omar7altawil/Sumo-Robot/README.md

# Sumo-Robot

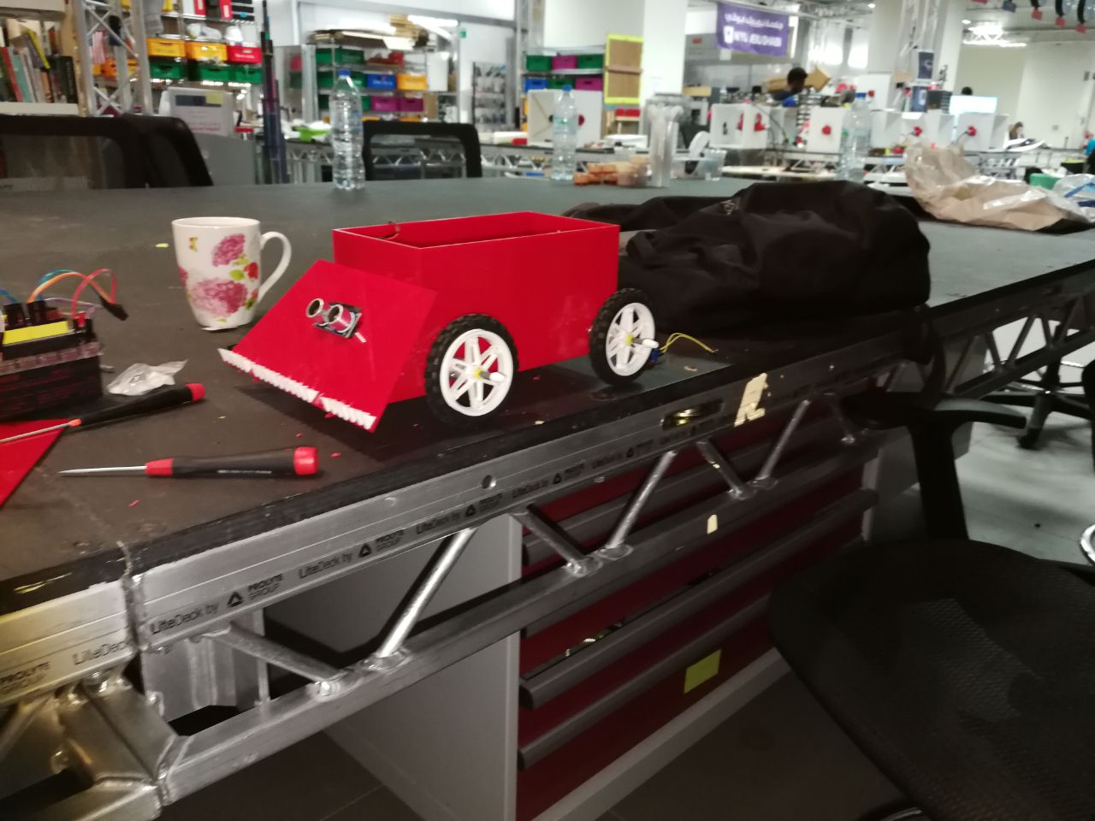
[picture p1: 3D/1.png]


Our project is about designing, assembling and programming our own Sumo
Robot. We had a budget of 100 US Dollar and were not allowed to exceed
it.At the end of the semester, there were a competition to see which Sumo
Robot is better and we will hopefully win the competition.

for the full report read(Project_micro.pdf)
