omar7altawil/Sumo-Robot/Micro_Project.pdf

# Project Report

# Sumo Robot Using Arduino

Ahmad Hashi 1046819

Omar Altawil 1047982

Mohamed Alnuaimi 1059177

Mohammed Tareq 1059223

Supervised By: Prof.Mohammad Ghazal

Eng. Yasmina Al Khalil

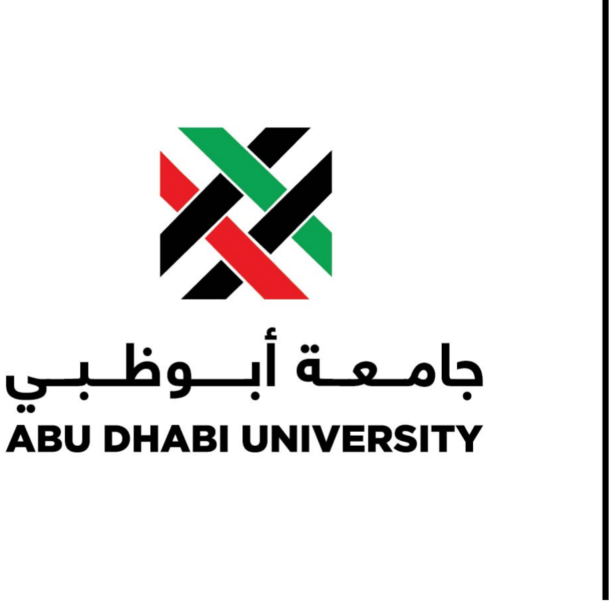
[picture p2: figure]

Submitted: December 15, 2017

1

# Contents

1 Introduction | 3
2 Procedure | 3
2.1 Motors | | 3
2.2 Sensors | | 6
2.3 The Chassis | 13
2.4 Extra : The Piezo | 17
2.5 The FSM | 19
2.6 The Final Code | 20
3 Conclusion | 29
4 Appendix | 29

# List of Figures

1 | The Motor Shield | | 4
2 | The H-Bridge | | 5
3 | The L9110S | | 5
4 | The L298n | | 6
5 | The Ultrasonic sensor | | 7
6 | The IR sensor | | 8
7 | The Remote controller(IR) | 10
8 | The Remote controller(Bluetooth) | 12
9 | PCB Broad 1 | 13
10 | PCB Broad 2 | 14
11 | The 3D Model | 15
12 | The Wheels | 15
13 | The Final Chassis | 16
14 | The Connections | 16
15 | The Wheel | 17
16 | The Piezo | 17
17 | The Final FSM | 19

2

# List of Tables

Abstract

This project is about creating you’re own Sumo Robot, designing and coding were up to us in the process of making our Robot.The winner of the Sumo Robot fight competition will be considered the best Robot design.The process of making our robot included making a PCB design, a 3D Design and a Design using some plastic and laser cutting. We faced a lot of challenges through out our project mainly on the chassis part. The coding was very fun to do, and we feel like we learned a lot about the embedded systems thanks to this project.

# 1 Introduction

Our project is about designing, assembling and programming our own Sumo Robot. We had a budget of 100 US Dollar and were not allowed to exceed it.At the end of the semester, there were a competition to see which Sumo Robot is better and we will hopefully win the competition.

# 2 Procedure

Here, we are going to talk about everything that we did, including the dif-ficulties that we faced, and we will end up with the FSM and the Final code.

## 2.1 Motors

In our robot, we had four 12 V DC motors which were supplied using a 12 volt(1.2AH)battery. some of the stuff didn’t make it to the final design due to reasons that are going to be mentioned and explained in the rest of the project report.

- Motor Shield : it’s driver module for motors that allows the user to control the state of the motor(on/off), the speed and the direction of the motor [1].We didn’t use the motor shield due to having insufficient pins for the rest of the sensors. A picture of the motor shield is shown in the figure 1.

3

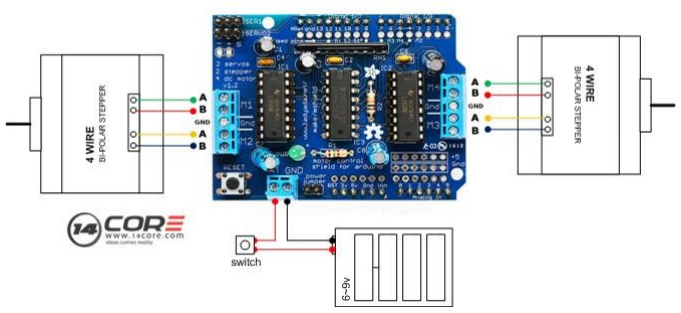
[picture p3: figure]

Figure 1: The Motor Shield

- L293d (H-Bridge) : To fix the problem that we faced with the Motor Shield, we decided to use L293d. We solider-out the l293d (2) from the motor shield, and we used to control the four motors. This was our ideal method of controlling the motors, the L293d had a very convenient size and it would have done its job fair and square.However, due to facing problems with the 3D design and the PCB print,we had to do the soldering by ourselves,but the connections were too big and it didn’t fit into our chassis.The L293d couldn’t make it to the final design.A picture of the L293d is shown in the figure 2.

4

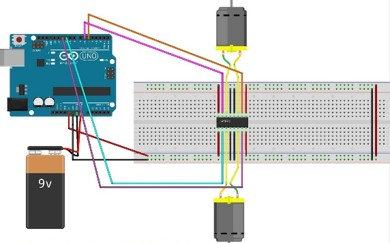
[picture p4: figure]

Figure 2: The H-Bridge

- L9110S : After having problems with the H-Bridge, we decided to use the L9110S motor driver. The L9110S was small, cheap and would fit perfectly in our chassis, and according to its data sheet it said that it can handle an range from 3.5 to 12 volt which was exactly what we wanted. Yet again, we faced an other problem, when we supplied the L9110S with 12v it worked approximately for 30 seconds before burning up due to overheat. Thus,the L9110S couldn’t make it to the final design.A picture of the L9110S is shown in the figure 3.

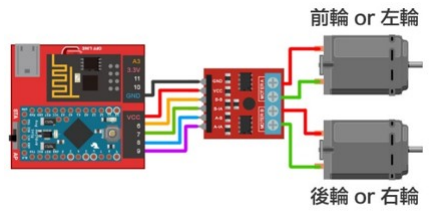
[picture p5: figure]

Figure 3: The L9110S

5

- L298n : we got this motor driver as a final solution, although the size of this motor driver was not what we intended to have in the beginning, it was the only thing that would work without overheating nor taking extra pins and its connections were acceptable. Therefor,the L298n was included into our final design.A picture of the L298n is shown in the figure 4.

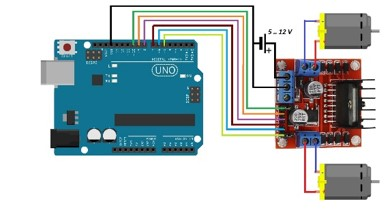
[picture p6: figure]

Figure 4: The L298n

## 2.2 Sensors

Sensors in general are devices that detects and responds to some type of input from the physical environment. The specific input could be light, heat, motion, moisture, pressure, or any one of a great number of other environmental phenomena [2].

- Ultrasonic sensor : An Ultrasonic sensor is a device that can measure the distance from object A to object B using sound waves.It measures distance by sending out a sound wave at a specific frequency and waits for its Eco to bounce back. By recording the elapsed time between the sound wave being generated and the sound wave bouncing back, it is possible to calculate the distance between the sonar sensor and the object [3]. We used this sensor to detect whether there is an other robot in front of our robot or not.A picture of the Ultrasonic sensor is shown in the figure 5.

6

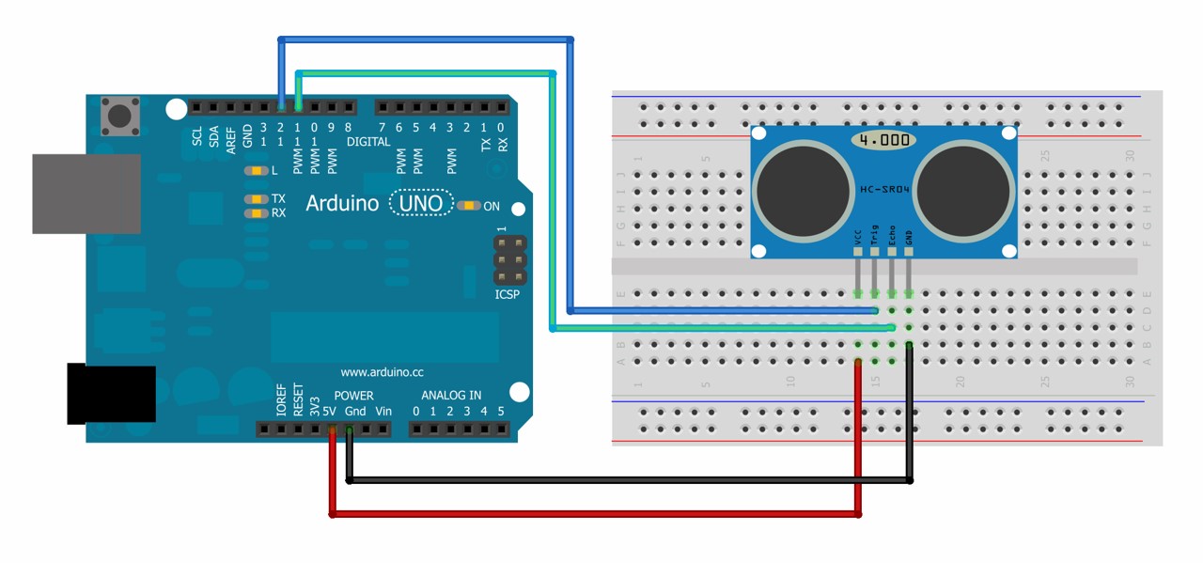
[picture p7: figure]

Figure 5: The Ultrasonic sensor

In the code, instead of using pulseIn() function, we included < NewP ing.h > library [4]. The test code of the sensor is shown downward :-

1 | #include <NewPing.h>
2 | #define TRIGGER_PIN A5
3 | #define ECHO_PIN | A5
4 | #define MAX_DISTANCE 200

5
6 NewPing sonar(TRIGGER_PIN, ECHO_PIN, MAX_DISTANCE);

7
8 | void setup() {
9 | Serial.begin(9600);
10 | pinMode(A0,OUTPUT);
11 | }

12
13 | void loop() {
14 | delay(50);
15 | Serial.print("Ping: ");
16 | Serial.print(sonar.ping_cm());
17 | Serial.println("cm");

18
19 | if(sonar.ping_cm()<8 && sonar.ping_cm()>0 )
20 | digitalWrite(A0,HIGH);
21 | if(sonar.ping_cm()>8)
22 | digitalWrite(A0,LOW);
23 | }

7

We used the function sonar.pingcm() to obtain the distance in cm. In the test code, we made the sensor work in a range of 0 to 200 cm in the new ping constructor and we set up a range of 0 to 8 cm for our output X to be HIGH. We had a delay of 50 milliseconds between each ping.

- IR Sensor : IR Sensor works by using a specific light sensor to detect a select light wavelength in the Infra-Red (IR) spectrum. The sensor has two main parts, one part sends the IR while the other part senses the reflected light, so it is possible to have a sensor that can return the value of the reflected light and it can be used to measure how ”bright” the object is [5].We used the IR sensor to detect whether the robot has reached the edge of the arena or not.A picture of the IR sensor is shown in the figure 6.

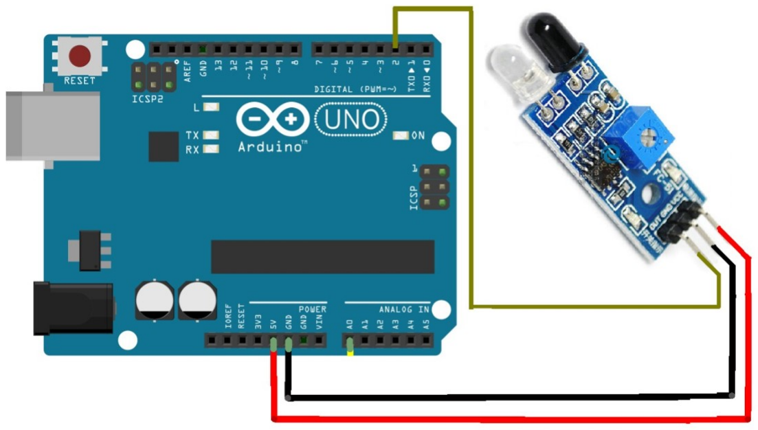
[picture p8: figure]

Figure 6: The IR sensor

8

This is our test code for the IR sensor :-

1 | int obstaclePin = 6; // This is our input pin
2 | int hasObstacle = LOW; // HIGH MEANS NO OBSTACLE

3
4 | void setup() {
5 | pinMode(A0, OUTPUT);
6 | pinMode(obstaclePin, INPUT);
7 | Serial.begin(9600);
8 | }
9 | void loop() {
10 | hasObstacle = digitalRead(obstaclePin); //Reads the output
| of the obstacle sensor from the 7th PIN of the Digital
| section of the arduino
11 | if (hasObstacle == HIGH) //LOW means something is ahead, so
| it illuminates the 13th Port connected to an LED
12 | {
13 | Serial.println("Stop something is ahead!!");
14 | digitalWrite(7, HIGH);//Illuminates the 13th Port LED
15 | }
16 | else
17 | {
18 | Serial.println("Path is clear");
19 | digitalWrite(7, LOW);
20 | }
21 | delay(200);
22 | }

In the test code, when hasObstacle is HIGH it means that the sensor is saying that there is some obstacle ahead and then a light is turned on to indicate that.

- The Remote controller : Our first choice was the IR remote controller due to its simplicity and reasonable price, but we didn’t use it because we faced A weird problem with it, the sensor stopped responding when the motors started moving. After debugging we noticed that the IR sensor works fine within 0 to 70 of analog input and when we tried to exceed that range it stops working. More debugging led us to notice that if we put the IR sensor away from the motor it works fine (up to
255) so the problem might be with the magnetic field that is generated

9

by the motors.A picture of the IR sensor is shown in the figure 7.

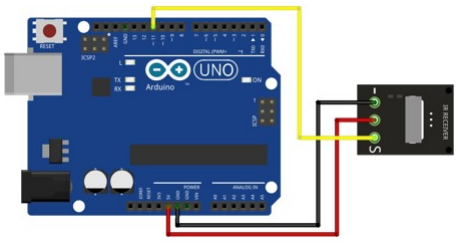
[picture p9: figure]

Figure 7: The Remote controller(IR)

In the test code for the remote using IR, we were controlling four motors. In order to use the IR remote, we had to include < IRremote.h > library.

1 #include <IRremote.h>

2
3 | int RECV_PIN = A4;
4 | IRrecv irrecv(RECV_PIN);
5 | decode_results results;

6
7 | #define BUTTON_front 0xEFA25D
8 | #define BUTTON_back 0xEFB24D
9 | #define BUTTON_left 0xEF50AF
10 | #define BUTTON_right 0xEF12ED
11 | #define BUTTON_speedup 0xEFE817
12 | #define BUTTON_speeddown 0xEF6897

13
14 | void setup()
15 | {
16 | Serial.begin(9600);
17 | irrecv.enableIRIn();
18 | }
19 | void loop() {
20 | if (irrecv.decode(&results)){

10

21 | Serial.println(results.value, HEX );
22 | if (results.value == BUTTON_front){
23 | // do something | }
24 | if (results.value == BUTTON_back){
25 | // do something | }
26 | if (results.value == BUTTON_back){
27 | // do something
28 | }
29 | if (results.value == BUTTON_back){
30 | // do something
31 | }
32 | irrecv.resume();
33 | }
34 | }

We faced one problem in our code which was the fact that new ping
library and IR library were using the same timer (timer 1), so we edited
new ping library and changed the timerenablefromtruetof alse.Althoughwewereabletof ixoneproblem, theproblemwiththeunstablecontrolmadethissensorexcludedfromthef inaldesign.
- Bluetooth hc-05 : HC-05 module is an easy to use Bluetooth SPP (Serial Port Protocol) module, designed for transparent wireless serial connection setup.It can function as both master and slave or we can say its a transceiver device. Master in referring to the controller or the device who sends the control signal, while slave in referring to the device that receives and obeys the control signal [6].We used a mobile app to control our robot via Bluetooth.A picture of the hc-05 sensor is shown in the figure 8.

The test code for the Bluetooth sensor is shown downward :-

1 | int state;
2 | int flag=0;
3 | int stateStop=0;
4 | void setup() {

5
6 | Serial.begin(9600);
7 | }

8
9 | void loop() {
10 | if(Serial.available() > 0){

11

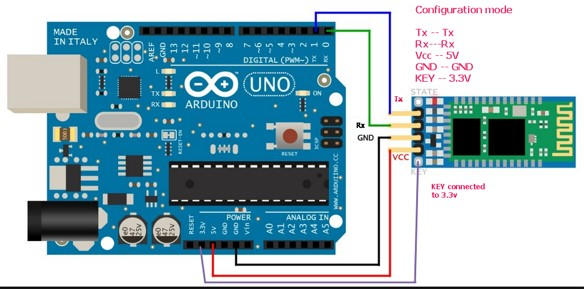
[picture p10: figure]

Figure 8: The Remote controller(Bluetooth)

11 | state = Serial.read();
12 | flag=0;
13 | }
14 | if (state == ’u’) {
15 | // Do something
16 | if(flag == 0){
17 | Serial.println("u is pressed");
18 | flag=1;
19 | }
20 | }
21 | else if (state == ’d’) {
22 | // Do something
23 | if(flag == 0){
24 | Serial.println("d is pressed");
25 | flag=1;
26 | }
27 | }
28 | else if (state == ’s’ || stateStop == 1) {
29 | // Do something
30 | if(flag == 0){
31 | Serial.println("s is pressed");
32 | flag=1;
33 | }
34 | stateStop=0;
35 | }
36 | else if (state == ’a’) {

12

37 | // Do something
38 | if(flag == 0){
39 | Serial.println("a is pressed");
40 | flag=1;
41 | }
42 | stateStop=0;
43 | }

44

45 }

## 2.3 The Chassis

Here we discuss how did we make our chassis.

- PCB Print :- A printed circuit board (PCB) is a board base for physi-cally supporting and wiring the surface-mounted and socketed compo-nents in most electronics [7].This was what we intended to have in the beginning of our project, but due to not having enough time and the 3D modeling problem, the PCB print of our circuit didn’t make it to the final design.We used eagle to design our PCB,and a picture of the design is shown in the figure 9 and 10.

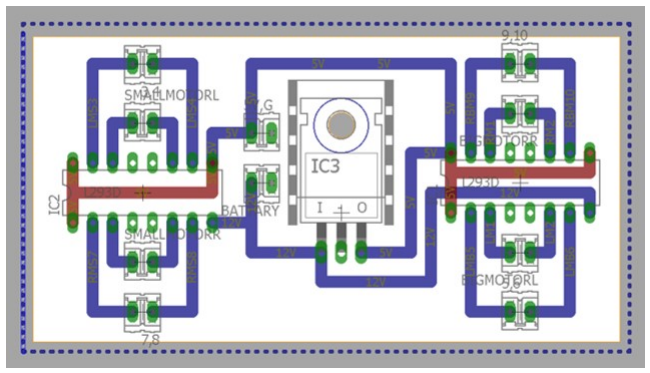
[picture p11: figure]

Figure 9: PCB Broad 1

13

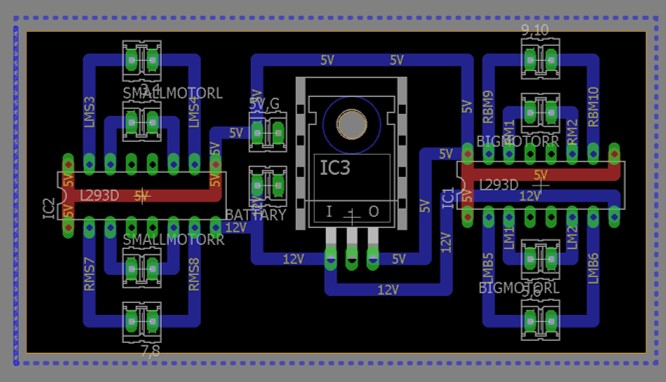
[picture p12: figure]

Figure 10: PCB Broad 2

- 3D Print :- A 3D printer is a computer-aided manufacturing (CAM) device that creates three-dimensional objects. Like a traditional printer, a 3D printer receives digital data from a computer as input. However, instead of printing the output on paper, a 3D printer builds a three-dimensional model out of a custom material [8].We made a 3D design of our chassis using Tinkercad, and printed it in the labs, our design had a length of 20 cm, a weight of 15 cm and a height of 6 cm. After printing, we were surprised that after the rescaling process, the design shrinked significantly and it didn’t even fit one motor, thus we were not able to use it and it wasn’t included in the final design.A picture of the 3D model is shown in the figure 11 and 12.

14

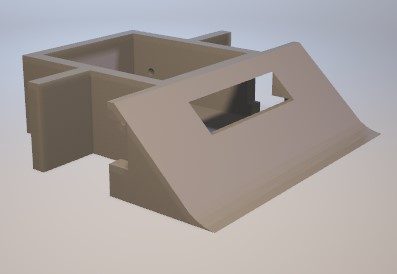
[picture p13: figure]

Figure 11: The 3D Model

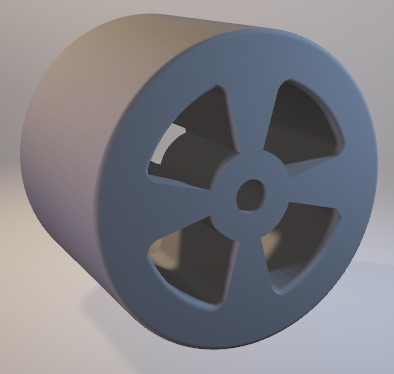
[picture p14: figure]

Figure 12: The Wheels

- plastic Laser Cutting :- This was our last resolve, getting thick pieces of plastic and use laser to form it in our desired shape.A picture of the final model and it’s connections are shown in the figure 13, 14 and 15.

15

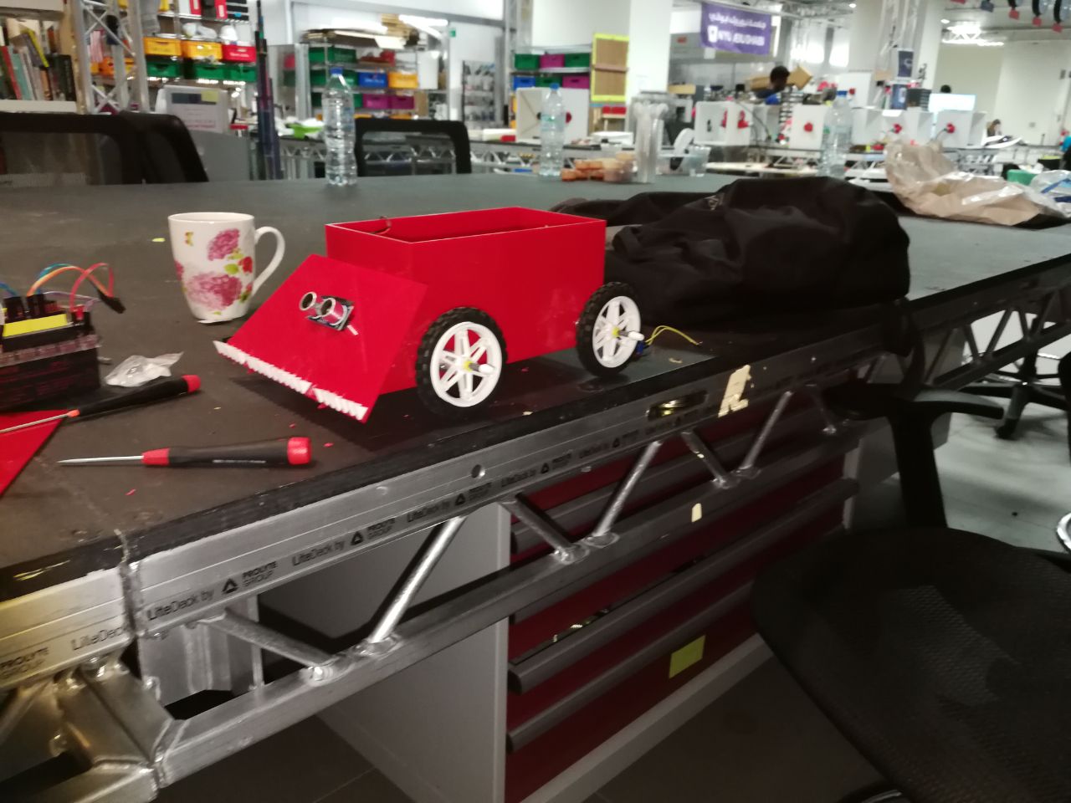
[picture p15: figure]

Figure 13: The Final Chassis

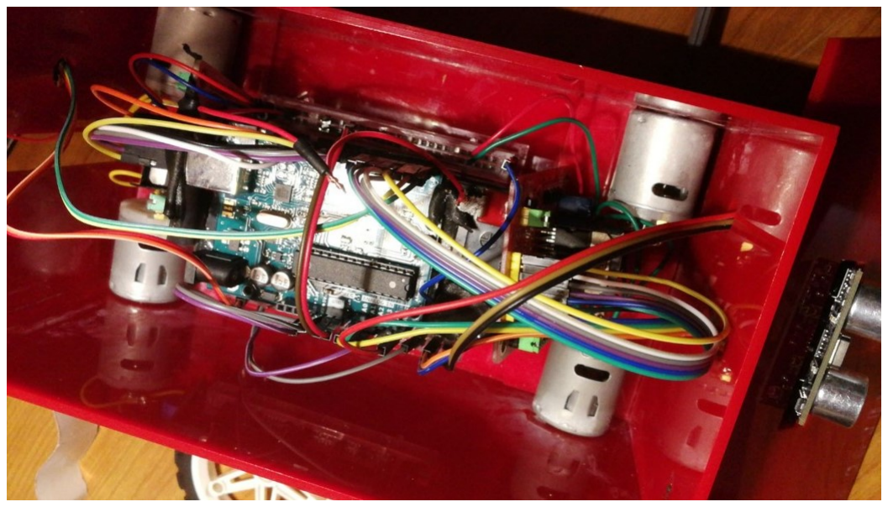
[picture p16: figure]

Figure 14: The Connections

16

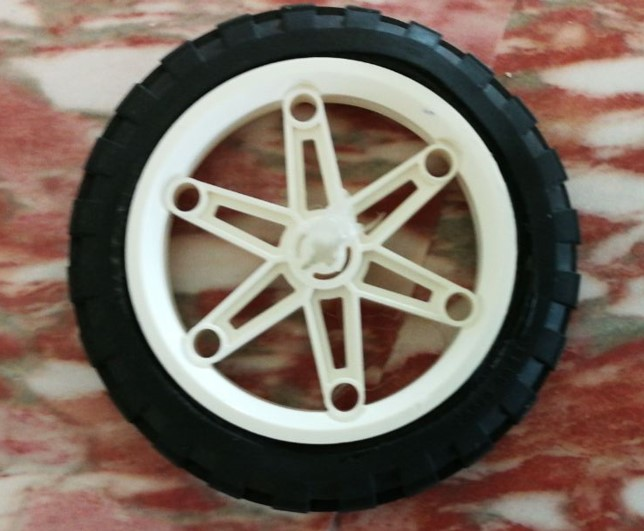
[picture p17: figure]

Figure 15: The Wheel

## 2.4 Extra : The Piezo

Piezoelectricity, also called the piezoelectric effect, is the ability of certain materials to generate an AC (alternating current) voltage when subjected to mechanical stress or vibration, or to vibrate when subjected to an AC voltage, or both. The most common piezoelectric material is quartz. Certain ceramics, Rochelle salts, and various other solids also exhibit this effect. A Piezo is a device that uses the piezoelectric effect to generate sounds on certain frequency [9]. The function tone() allows us to decide the frequency of the sound that we want to hear.A picture of the Piezo is shown in the figure 16 and the test code in also downward,we used it in the final code to play Star war song.

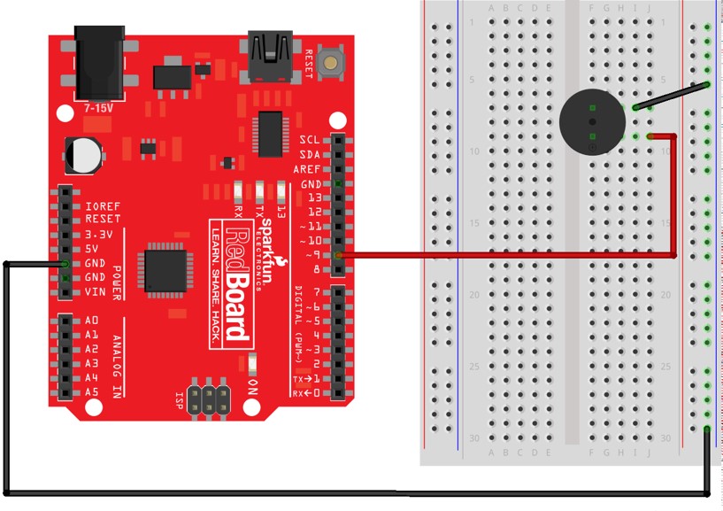
[picture p18: figure]

Figure 16: The Piezo

17

1 | void setup()
2 | {
3 | Serial.begin(9600);
4 | }

5
6 | void loop()
7 | {
8 | if (something)
9 | {
10 | tone(7,analogRead(A1),1000);
11 | }

12
13 | Serial.println(analogRead(A1));
14 | }

18

## 2.5 The FSM

This is our final FSM for the project :-

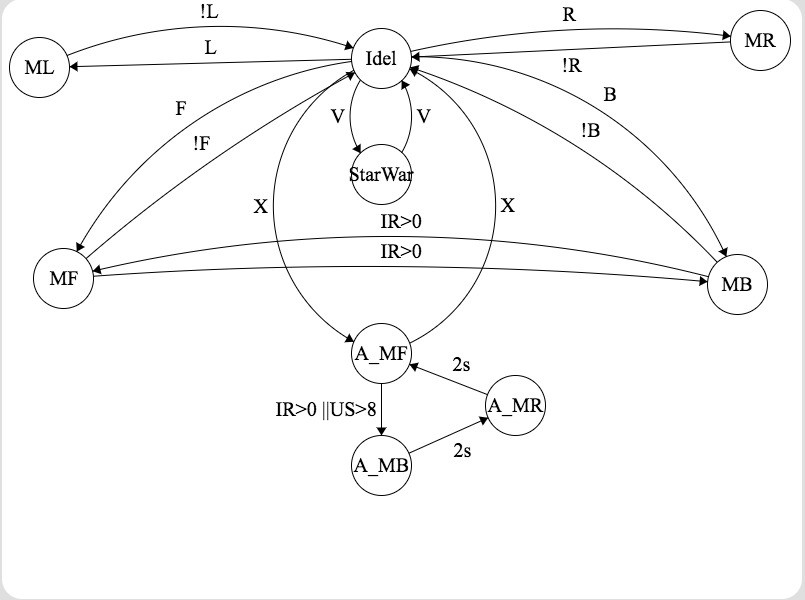
[picture p19: figure]

Figure 17: The Final FSM

19

## 2.6 The Final Code

This is our final code, everything is explained in the comments.

1 | //calling newPing library to control ultrasoinc
2 | #include <NewPing.h>
3 | //define all the state that we have in the FSM
4 | enum {Idle,MovingForward,Backward,Turnleft,Turnright,
5 | Turn,AM_Backward,AM_MovingForward};
6 | //define initial state to be Idle
7 | int currentState = Idle;
8 | // define the speed for the 4 motor to controll them later
9 | int bmr,bml,smr,sml;
10 | //right back motor(PWM)
11 | #define Enable11 11
12 | //right back motor(direction)
13 | #define ControlMotor13 13
14 | #define ControlMotor12 12
15 | ///left back motor(PWM)
16 | #define Enable10 10
17 | ///left back motor(direction)
18 | #define ControlMotor9 9
19 | #define ControlMotor8 8
20 | ///left small motor(PWM)
21 | #define Enable6 6
22 | ///left small motor(direction)
23 | #define ControlMotor7 7
24 | #define ControlMotor5 5
25 | ///right small motor(PWM)
26 | #define Enable3 3
27 | ///right small motor(direction)
28 | #define ControlMotor4 4
29 | #define ControlMotor2 2
30 | //define the state that we gone use to read the output from the
| blutooth
31 | int state;
32 | /////////////////////////////
33 | //PIZO
34 | #define buzzerPin A2
35 | //define freucancy srt of(STAR WAR Song)
36 | const int c = 261;const int d = 294;const int e = 329;const int f
| 20

= 349;const int g = 391;const int gS = 415;const int a = 440;const int aS = 455;const int b = 466;const int cH = 523;const int cSH = 554;const int dH = 587;const int dSH = 622;const int eH = 659;const int fH = 698;const int fSH = 740;const int gH = 784;const int gSH = 830;const int aH = 880;
37 | //counter for the pizo delay
38 | int counter = 0;
39 | //IR (edge sensor)
40 | #define IRS A5
41 | //ultrasoinc (distance sensor)
42 | #define TRIGGER_PIN A0
43 | #define ECHO_PIN | A1
44 | //the MAX DISTANCE that the Ultrasoinc will detect
45 | #define MAX_DISTANCE 200
46 | //define the paremter for sonar method from the NewPing libray
47 | NewPing sonar(TRIGGER_PIN, ECHO_PIN, MAX_DISTANCE);

48
49 | void setup() {
50 | //display Output in the serial monitor,buad is 9600
51 | Serial.begin(9600);
52 | //PIZO is an Output
53 | pinMode(buzzerPin,OUTPUT);
54 | //(PWM pin)to controll the speed for back right motor
55 | pinMode(Enable11, OUTPUT);
56 | //(PWM pin)to controll the speed for back left motor
57 | pinMode(Enable10, OUTPUT);
58 | //(PWM pin)to controll the speed for small left motor
59 | pinMode(Enable6, OUTPUT);
60 | //(PWM pin)to controll the speed for small right motor
61 | pinMode(Enable3, OUTPUT);
62 | //to controll the diraction of the back right motor
63 | pinMode(ControlMotor13, OUTPUT);
64 | pinMode(ControlMotor12, OUTPUT);
65 | //to controll the diraction of the back left motor
66 | pinMode(ControlMotor9, OUTPUT);
67 | pinMode(ControlMotor8, OUTPUT);
68 | //to controll the diraction of the small left motor
69 | pinMode(ControlMotor7, OUTPUT);
70 | pinMode(ControlMotor5, OUTPUT);
71 | //to controll the diraction of the small right motor

21

72 | pinMode(ControlMotor4, OUTPUT);
73 | pinMode(ControlMotor2, OUTPUT);
74 | }

75

76

77
78 | void loop() {
79 | //Calling IRInputCheck method which will check the output from
| the Buletooth
80 | IRInputCheck();}

81

82

83
84 | //PIZO(StarWar) START
85 | //beep method take two paremters(frecuany and duration).
86 | void beep(int note, int duration)
87 | {if(state==’V’){tone(buzzerPin, note, duration);if(counter % 2 ==
| 0){delay(duration);}else{delay(duration);}noTone(buzzerPin);delay(50);counter++;}}
88 | //this is the first saction of the star war song
89 | void firstSection(){
90 | beep(a,500);beep(a,500);beep(a,500);beep(f,350);
91 | beep(cH,150);beep(a,500);beep(f,350);beep(cH,150);beep(a,650);
92 | delay(500);
93 | beep(eH,500);beep(eH,500);beep(eH,500);beep(fH,350);
94 | beep(cH,150);beep(gS,500);beep(f,350);beep(cH,150);beep(a,650);
95 | delay(500);}
96 | //this is the second saction of the star war song
97 | void secondSection(){
98 | beep(aH,500);beep(a,300);beep(a,150);beep(aH,500);
99 | beep(gSH,325);beep(gH,175);beep(fSH,125);beep(fH,125);beep(fSH,250);
100 | delay(325);
101 | beep(aS,250);beep(dSH,500);beep(dH,325);
102 | beep(cSH,175);beep(cH,125);beep(b,125);beep(cH,250);
103 | delay(350);}
104 | //this is the third saction of the star war song
105 | void thardpart(){beep(f,250);beep(gS,500);beep(f,350);beep(a,
| 125);beep(cH,500);beep(a,375);beep(cH,125);beep(eH,650);
106 | delay(500);
107 | secondSection();beep(f,250);beep(gS,500);beep(f,375);
108 | beep(cH,125);beep(a,500);beep(f,375);beep(cH,125);beep(a,650);

22

109 | delay(650);}
110 | //PIZO END

111

112
113 | //this method lisean for the BLUETHOOTH
114 | void IRInputCheck() {
115 | //cheack if there is signal coming from the bluethooth
116 | if(Serial.available() > 0){
117 | //we set the state to what the bluetooth send
118 | state = Serial.read();}
119 | //chack the state output
120 | //state can be 3 type of button
121 | //(Swith Button)first press (on),second press (off)
122 | //(Press Button)pressing (on),stop pressing (off)
123 | //(moveing bar)eacth move for the bar triger a diffrent button.
124 | switch (state) {
125 | //when no button is pressed
126 | default :
127 | Serial.println("Idle");
128 | //currentState go to the Idle
129 | currentState = Idle;
130 | //shut down all motors
131 | digitalWrite(ControlMotor13, LOW);
132 | digitalWrite(ControlMotor12, LOW);
133 | digitalWrite(ControlMotor9, LOW);
134 | digitalWrite(ControlMotor8, LOW);
135 | digitalWrite(ControlMotor7, LOW);
136 | digitalWrite(ControlMotor5, LOW);
137 | digitalWrite(ControlMotor4, LOW);
138 | digitalWrite(ControlMotor2, LOW);
139 | break;
140 | //when X is pressed(Swith Button)
141 | case ’X’:
142 | //currentState go to the AM_MovingForward
143 | //this is the auto obstacle avoider
144 | currentState = AM_MovingForward;
145 | //if the currentState is AM_MovingForward
146 | if (currentState == AM_MovingForward) {
147 | Serial.println("AM_MovingForward");
148 | //set the speed of the motors

23

149 | analogWrite(Enable11, bmr); analogWrite(Enable10, bml);
150 | analogWrite(Enable6, smr); analogWrite(Enable3, sml);
151 | //all motors go forward
152 | digitalWrite(ControlMotor13, LOW);
153 | digitalWrite(ControlMotor12, HIGH);
154 | digitalWrite(ControlMotor9, LOW);
155 | digitalWrite(ControlMotor8, HIGH);
156 | digitalWrite(ControlMotor7, LOW);
157 | digitalWrite(ControlMotor5, HIGH);
158 | digitalWrite(ControlMotor4, LOW);
159 | digitalWrite(ControlMotor2, HIGH);
160 | //if the car about to fall
161 | if (digitalRead(IRS) == HIGH)
162 | //currentState is AM_Backward
163 | currentState = AM_Backward ;
164 | //if the car about to hit somthing that far from us 8cm
165 | //snor.ping_cm retuen the distance of the object in cm
166 | if(sonar.ping_cm()<8 && sonar.ping_cm()>0 )
167 | //currentState is AM_Backward
168 | currentState = AM_Backward ;
169 | }
170 | //if the currentState is AM_MovingForward
171 | if (currentState == AM_Backward) {
172 | Serial.println("AM_Backward");
173 | //set the speed of the motors
174 | analogWrite(Enable11, bmr); analogWrite(Enable10, bml);
175 | analogWrite(Enable6, smr); analogWrite(Enable3, sml);
176 | //all motors go backward
177 | digitalWrite(ControlMotor13, HIGH);
178 | digitalWrite(ControlMotor12, LOW);
179 | digitalWrite(ControlMotor9, HIGH);
180 | digitalWrite(ControlMotor8, LOW);
181 | digitalWrite(ControlMotor7, HIGH);
182 | digitalWrite(ControlMotor5, LOW);
183 | digitalWrite(ControlMotor4, HIGH);
184 | digitalWrite(ControlMotor2, LOW);
185 | //wait 2 s
186 | delay(2000);
187 | //currentState is Turn
188 | currentState = Turn;

24

189 | }
190 | if (currentState == Turn) {
191 | Serial.println("Turn");
192 | //set the speed of the motors
193 | analogWrite(Enable11, bmr); analogWrite(Enable10, bml);
194 | analogWrite(Enable6, smr); analogWrite(Enable3, sml);
195 | //motors Turn Right
196 | digitalWrite(ControlMotor13, HIGH);
197 | digitalWrite(ControlMotor12, LOW);
198 | digitalWrite(ControlMotor9, LOW);
199 | digitalWrite(ControlMotor8, LOW);
200 | digitalWrite(ControlMotor7, HIGH);
201 | digitalWrite(ControlMotor5, LOW);
202 | digitalWrite(ControlMotor4, LOW);
203 | digitalWrite(ControlMotor2, LOW);
204 | //wait 2 s
205 | delay(2000);
206 | //currentState is AM_MovingForward(after we escape the
| obstacle we continue moving)
207 | currentState = AM_MovingForward;
208 | }
209 | break;
210 | //when F is pressed(press button)
211 | case ’F’:
212 | //currentState is MovingForward
213 | currentState = MovingForward;
214 | if(currentState==MovingForward){
215 | Serial.println("Moving Forward");
216 | //set the speed of the motors
217 | analogWrite(Enable11, bmr); analogWrite(Enable10, bml);
218 | analogWrite(Enable6, smr); analogWrite(Enable3, sml);
219 | //all motors go forward
220 | digitalWrite(ControlMotor13, LOW);
221 | digitalWrite(ControlMotor12, HIGH);
222 | digitalWrite(ControlMotor9, LOW);
223 | digitalWrite(ControlMotor8, HIGH);
224 | digitalWrite(ControlMotor7, LOW);
225 | digitalWrite(ControlMotor5, HIGH);
226 | digitalWrite(ControlMotor4, LOW);
227 | digitalWrite(ControlMotor2, HIGH);

25

228 | //if the car about to fall
229 | if (digitalRead(IRS) == HIGH)
230 | //move back
231 | state=’B’;
232 | }
233 | //when B is pressed(press button)
234 | case ’B’:
235 | Serial.println("Backward");
236 | //currentState is Backward
237 | currentState = Backward;
238 | //set the speed of the motors
239 | analogWrite(Enable11, bmr); analogWrite(Enable10, bml);
240 | analogWrite(Enable6, smr); analogWrite(Enable3, sml);
241 | //all motors go backward
242 | digitalWrite(ControlMotor13, HIGH);
243 | digitalWrite(ControlMotor12, LOW);
244 | digitalWrite(ControlMotor9, HIGH);
245 | digitalWrite(ControlMotor8, LOW);
246 | digitalWrite(ControlMotor7, HIGH);
247 | digitalWrite(ControlMotor5, LOW);
248 | digitalWrite(ControlMotor4, HIGH);
249 | digitalWrite(ControlMotor2, LOW);
250 | //if the car about to fall
251 | if (digitalRead(IRS) == HIGH)
252 | //move fowrard
253 | state=’F’ ;
254 | break;
255 | //when R is pressed(press button)
256 | case ’R’:
257 | Serial.println("Turn right");
258 | //currentState is Turnright
259 | currentState = Turnright;
260 | //set the speed of the motors
261 | analogWrite(Enable11, bmr); analogWrite(Enable10, bml);
262 | analogWrite(Enable6, smr); analogWrite(Enable3, sml);
263 | //motors Turnright
264 | digitalWrite(ControlMotor13, HIGH);
265 | digitalWrite(ControlMotor12, LOW);
266 | digitalWrite(ControlMotor9, LOW);
267 | digitalWrite(ControlMotor8, LOW);

26

268 | digitalWrite(ControlMotor7, HIGH);
269 | digitalWrite(ControlMotor5, LOW);
270 | digitalWrite(ControlMotor4, LOW);
271 | digitalWrite(ControlMotor2, LOW);
272 | break;
273 | //when L is pressed(press button)
274 | case ’L’:
275 | Serial.println("Turn left");
276 | //currentState is Turnleft
277 | currentState = Turnleft;
278 | //set the speed of the motors
279 | analogWrite(Enable11, bmr); analogWrite(Enable10, bml);
280 | analogWrite(Enable6, smr); analogWrite(Enable3, sml);
281 | //motors Turnleft
282 | digitalWrite(ControlMotor13, LOW);
283 | digitalWrite(ControlMotor12, HIGH);
284 | digitalWrite(ControlMotor9, LOW);
285 | digitalWrite(ControlMotor8, LOW);
286 | digitalWrite(ControlMotor7, LOW);
287 | digitalWrite(ControlMotor5, HIGH);
288 | digitalWrite(ControlMotor4, LOW);
289 | digitalWrite(ControlMotor2, LOW);
290 | break;
291 | //when V is pressed(Swith Button)
292 | case ’V’:
293 | Serial.println("PIZO");
294 | //play the (Star war song)
295 | firstSection();
296 | secondSection();
297 | thardpart();
298 | break;

299
300 | //controll the speed
301 | //when 0 is pressed(moveing bar)
302 | case ’0’:
303 | //set the speed to 0
304 | bmr=0;bml=0;smr=0;sml=0;
305 | break;
306 | //when 1 is pressed(moveing bar)
307 | case ’1’:

27

308 | //set the speed to 25
309 | bmr=25;bml=25;smr=25;sml=25;
310 | break;
311 | //when 2 is pressed(moveing bar)
312 | case ’2’:
313 | //set the speed to 50
314 | bmr=50;bml=50;smr=50;sml=50;
315 | break;
316 | //when 3 is pressed(moveing bar)
317 | case ’3’:
318 | //set the speed to 80
319 | bmr=80;bml=80;smr=80;sml=80;
320 | break;
321 | //when 4 is pressed(moveing bar)
322 | case ’4’:
323 | //set the speed to 100
324 | bmr=100;bml=100;smr=100;sml=100;
325 | break;
326 | //when 5 is pressed(moveing bar)
327 | case ’5’:
328 | //set the speed to 125
329 | bmr=125;bml=125;smr=125;sml=125;
330 | break;
331 | //when 6 is pressed(moveing bar)
332 | case ’6’:
333 | //set the speed to 150
334 | bmr=150;bml=150;smr=150;sml=150;
335 | break;
336 | //when 7 is pressed(moveing bar)
337 | case ’7’:
338 | //set the speed to 180
339 | bmr=180;bml=180;smr=180;sml=180;
340 | break;
341 | //when 8 is pressed(moveing bar)
342 | case ’8’:
343 | //set the speed to 205
344 | bmr=205;bml=205;smr=205;sml=205;
345 | break;
346 | //when 9 is pressed(moveing bar)
347 | case ’9’:

28

348 | //set the speed to 225
349 | bmr=225;bml=225;smr=225;sml=225;
350 | break;
351 | //when q is pressed(moveing bar)
352 | case ’q’:
353 | //set the speed to 255
354 | bmr=255;bml=255;smr=255;sml=255;
355 | break;
356 | }
357 | }
358 | //BLUETHOOTH END

# 3 Conclusion

In conclusion, The project was about making our own Sumo Robot.Our initial intentions were to design a PCb and a 3D model, then print both of them and use it as the base of our design. But we faced problems with both printing PCB and the 3D model for the chassis.We managed to solder the connection by ourselves, and made the body using laser cutting. Unfortunately, we were not able to participate in the Sumo competition due to a problem with the wheels, our motors were too strong for the wheels that we got from a Lego store.We used a round 83 US Dollar of our budget and were manage to save 17 US Dollars, more details are explained in the order proof.Ignoring the fact that we were not able to participate, the project was a really fun educational experience.

# 4 Appendix

Here the stuff that we have used :-

1. The 3D design
2. The PCB Design
3. The Order Proof
4. The .ion file for the code

29

# References

[1] (2015) | Motor | Shield. | [Online]. | Available:
http://wiki.seeedstudio.com/wiki/MotorShield
[2] M. | Rouse. | (2012) | Sensors. | [Online]. | Available:
http://whatis.techtarget.com/definition/sensor
[3] What | is | an | Ultrasonic | Sensor? | [Online]. | Available:
http://education.rec.ri.cmu.edu/content/electronics/boe/ultrasonicsensor/1.html
[4] T. Eckel. (2016) NewPing Library for Arduino. [Online]. Available: https://playground.arduino.cc/Code/NewPing
[5] What | is | an | IR | Sensor? | [Online]. | Available:
http://education.rec.ri.cmu.edu/content/electronics/boe/irsensor/1.html
[6] (2017) | Serial | Port | Bluetooth | Module | (Mas-
ter/Slave) | : | HC-05. | [Online]. | Available:
https://www.itead.cc/wiki/SerialP ortBluetoothModule(M aster/Slave):HC− 05
[7] M. Rouse. (2013) printed circuit board (PCB). [Online]. Available: http://whatis.techtarget.com/definition/printed-circuit-board-PCB
[8] P. | Christensson. | (2014) | 3D | Printer. | [Online]. | Available:
https://techterms.com/definition/3dprinter
[9] M. | Rouse. | (2016) | piezoelectricity. | [Online]. | Available:
http://whatis.techtarget.com/definition/piezoelectricity

30
