omar7altawil/Sumo-Robot/3D/sumo robot.stl

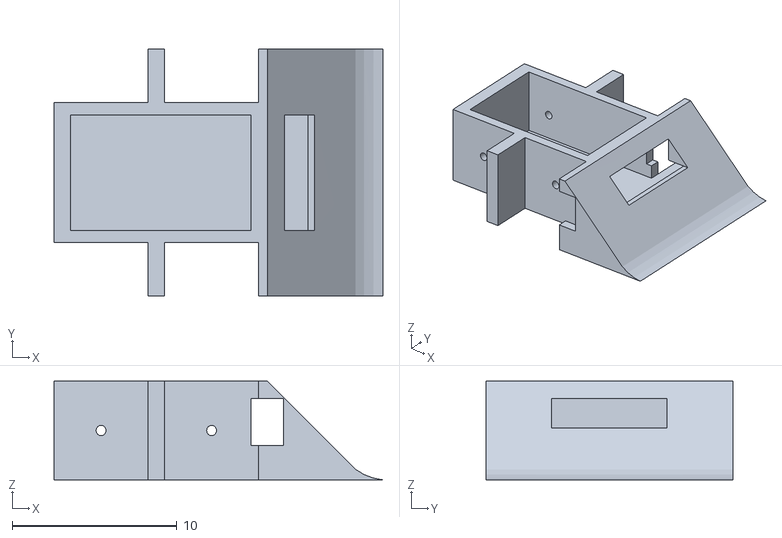
[picture p20: CAD file, 2019-02-12]
3D/sumo robot.stl
20.0 x 15.0 x 6.00
