omar7altawil/Sumo-Robot/3D/wheel.stl

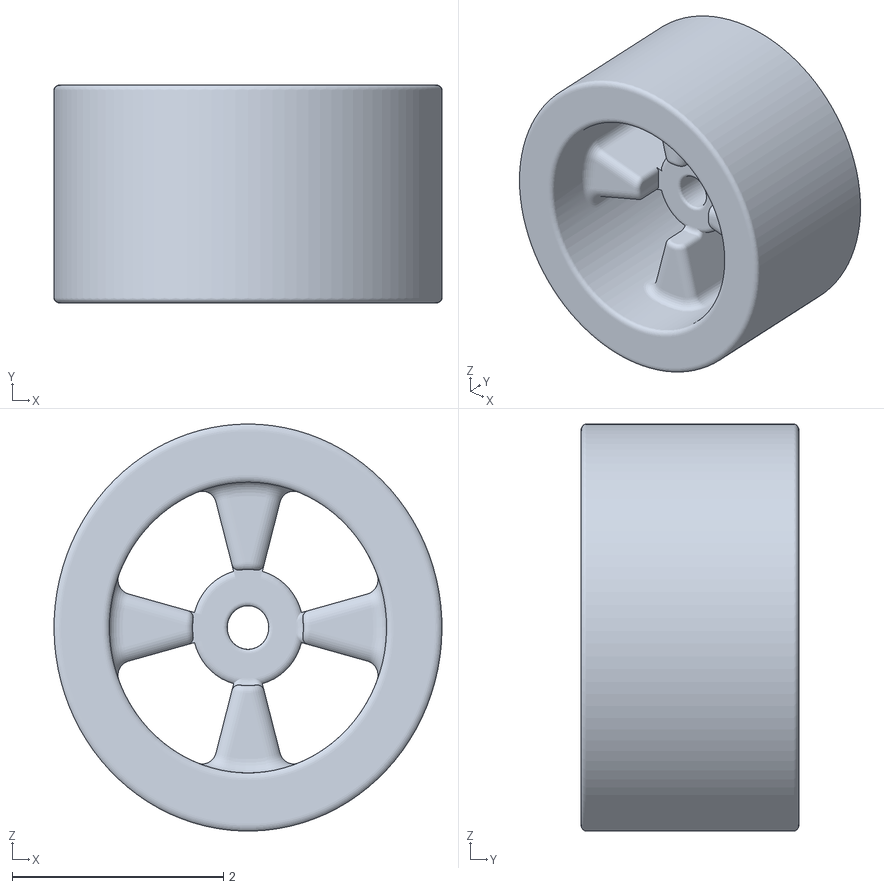
[picture p21: CAD file, 2019-02-12]
3D/wheel.stl
3.67 x 2.07 x 3.85
