omar7altawil/Sumo-Robot/PCB/PCB(final).brd

## EAGLE design PCB/PCB(final).brd (2019-02-12)

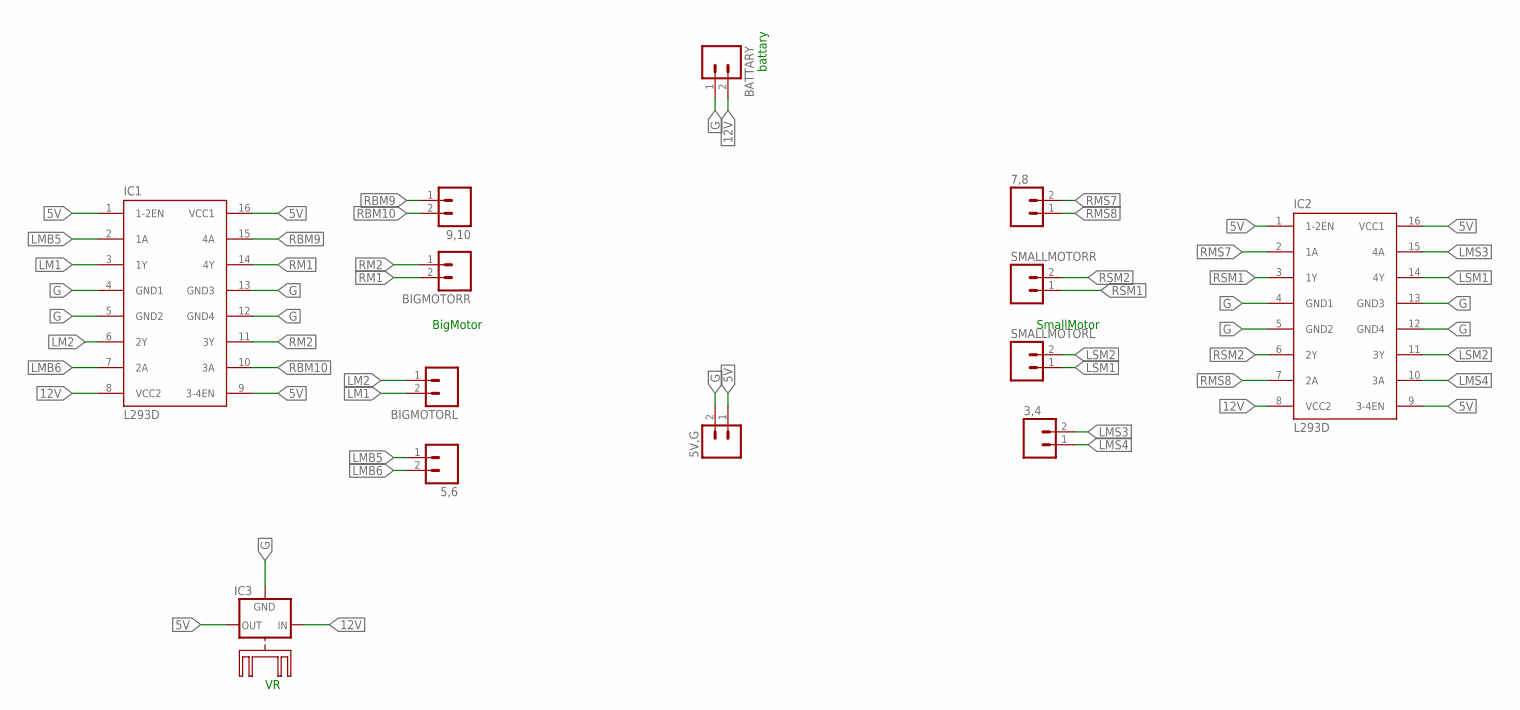
[picture p22: schematic PCB(final).sch]

Parts:
3,4, 5,6, 5V,G, 7,8, 9,10: M02; 02P
BATTARY: M02; 02P
BIGMOTORL: M02; 02P
BIGMOTORR: M02; 02P
IC1, IC2: L293D; DIL16
IC3: 78XXH
SMALLMOTORL: M02; 02P
SMALLMOTORR: M02; 02P

Connections:
5V: 5V,G.1, IC1.1 (1-2EN), IC1.9 (3-4EN), IC1.16 (VCC1), IC2.1 (1-2EN), IC2.9 (3-4EN), IC2.16 (VCC1), IC3.OUT
12V: BATTARY.2, IC1.8 (VCC2), IC2.8 (VCC2), IC3.IN
G: 5V,G.2, BATTARY.1, IC1.4 (GND1), IC1.5 (GND2), IC1.12 (GND4), IC1.13 (GND3), IC2.4 (GND1), IC2.5 (GND2), IC2.12 (GND4), IC2.13 (GND3), IC3.GND
LM1: BIGMOTORL.2, IC1.3 (1Y)
LM2: BIGMOTORL.1, IC1.6 (2Y)
LMB5: 5,6.1, IC1.2 (1A)
LMB6: 5,6.2, IC1.7 (2A)
LMS3: 3,4.2, IC2.15 (4A)
LMS4: 3,4.1, IC2.10 (3A)
LSM1: IC2.14 (4Y), SMALLMOTORL.1
LSM2: IC2.11 (3Y), SMALLMOTORL.2
RBM9: 9,10.1, IC1.15 (4A)
RBM10: 9,10.2, IC1.10 (3A)
RM1: BIGMOTORR.2, IC1.14 (4Y)
RM2: BIGMOTORR.1, IC1.11 (3Y)
RMS7: 7,8.2, IC2.2 (1A)
RMS8: 7,8.1, IC2.7 (2A)
RSM1: IC2.3 (1Y), SMALLMOTORR.1
RSM2: IC2.6 (2Y), SMALLMOTORR.2

Notes on the sheet:
battary
BigMotor
SmallMotor

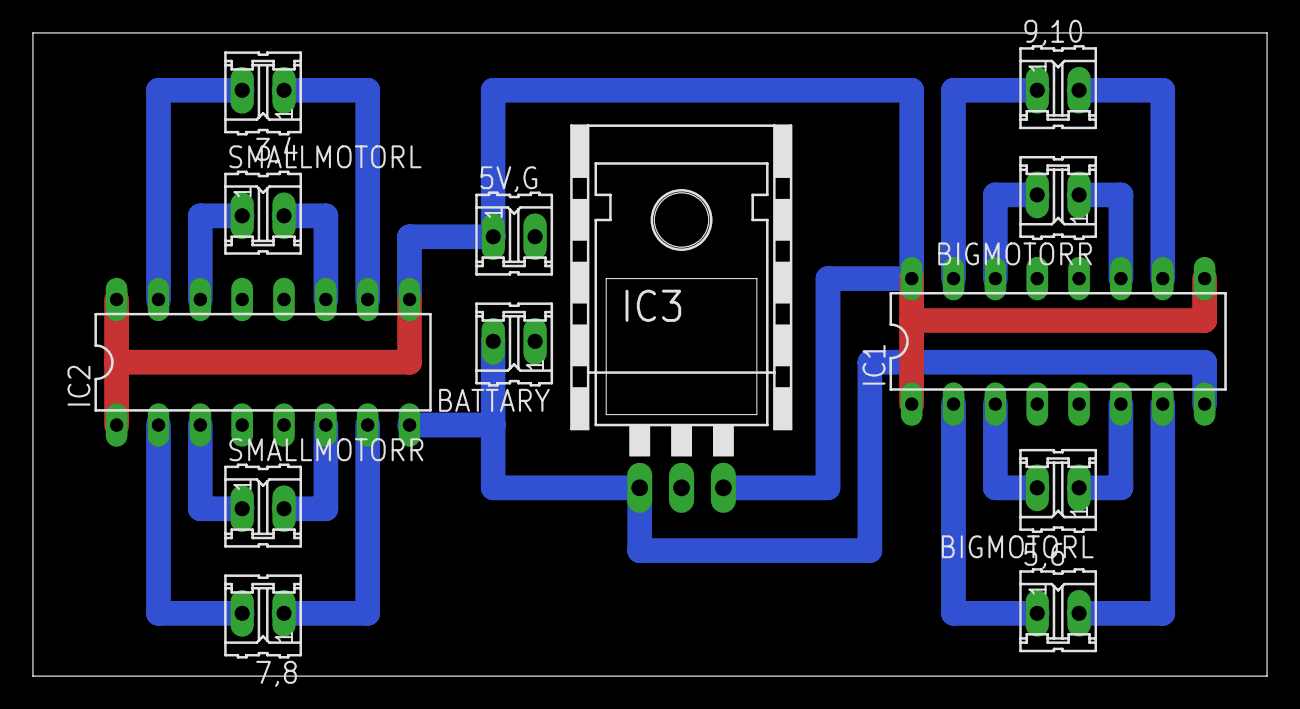
[picture p23: board PCB(final).brd from above]

Board: 2 copper layers, 74.9 x 39.0 mm, 13 parts (0 on the bottom side), 19 nets.
